ntabas00/hovercraft-/README.md

# hovercraft PROJECT IN ARDUINO LANGUAGE 
By:
Nabila Tabassum - 40109039
Alexandre Fontaine - 40158602
Rayan Alkayal - 40051210
Navid Mehrabi - 27552874
